Jochen0x90h/LedControl_old/Hardware2/Board/LedControl.kicad_pcb

## KiCad design Hardware2/Board/LedControl.kicad_pcb (2019-06-07)

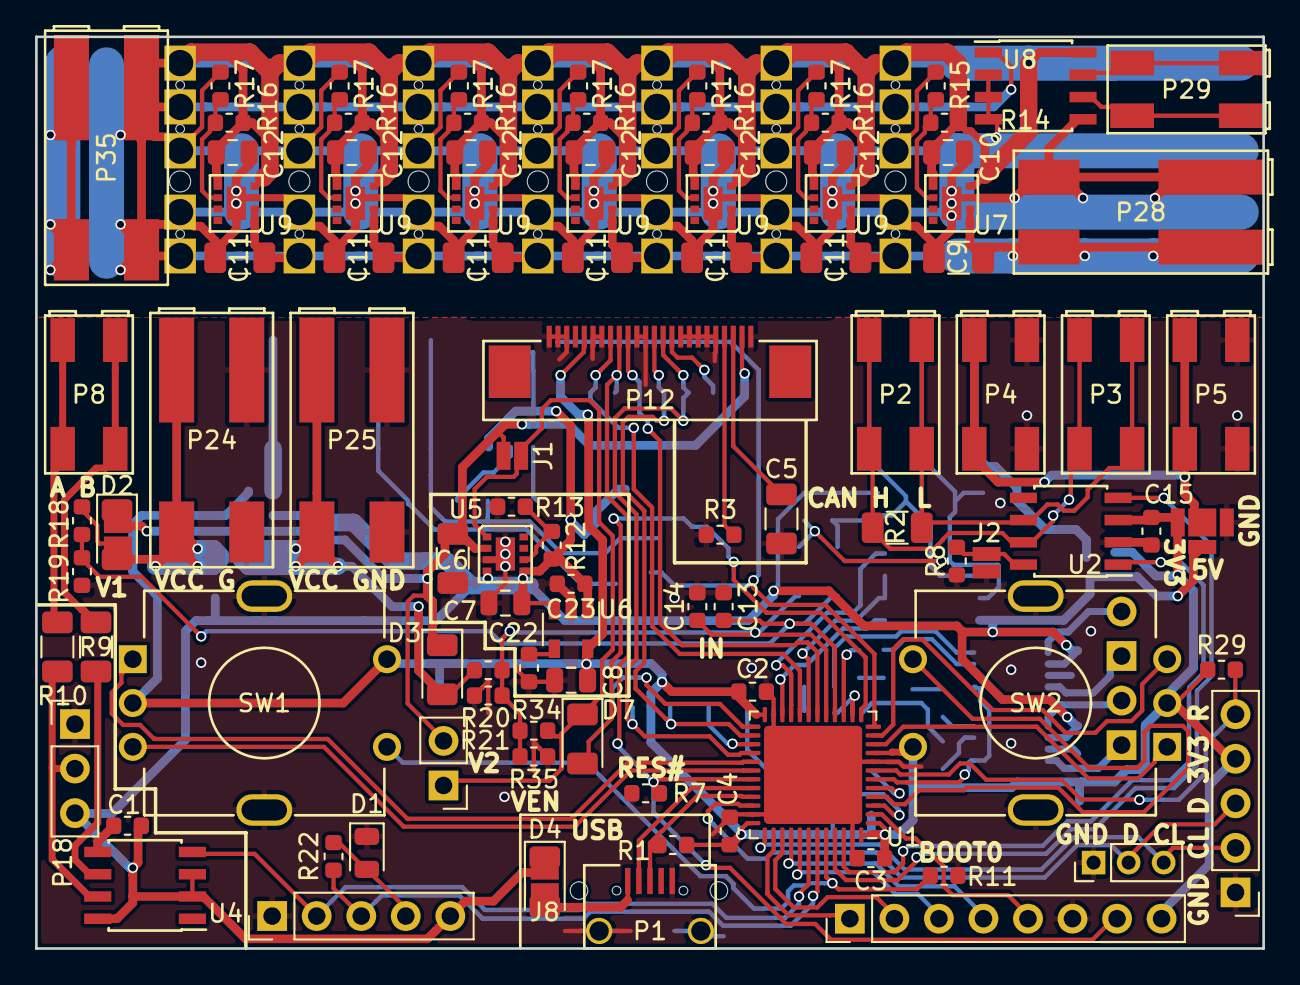
[picture p1: board LedControl.kicad_pcb from above]

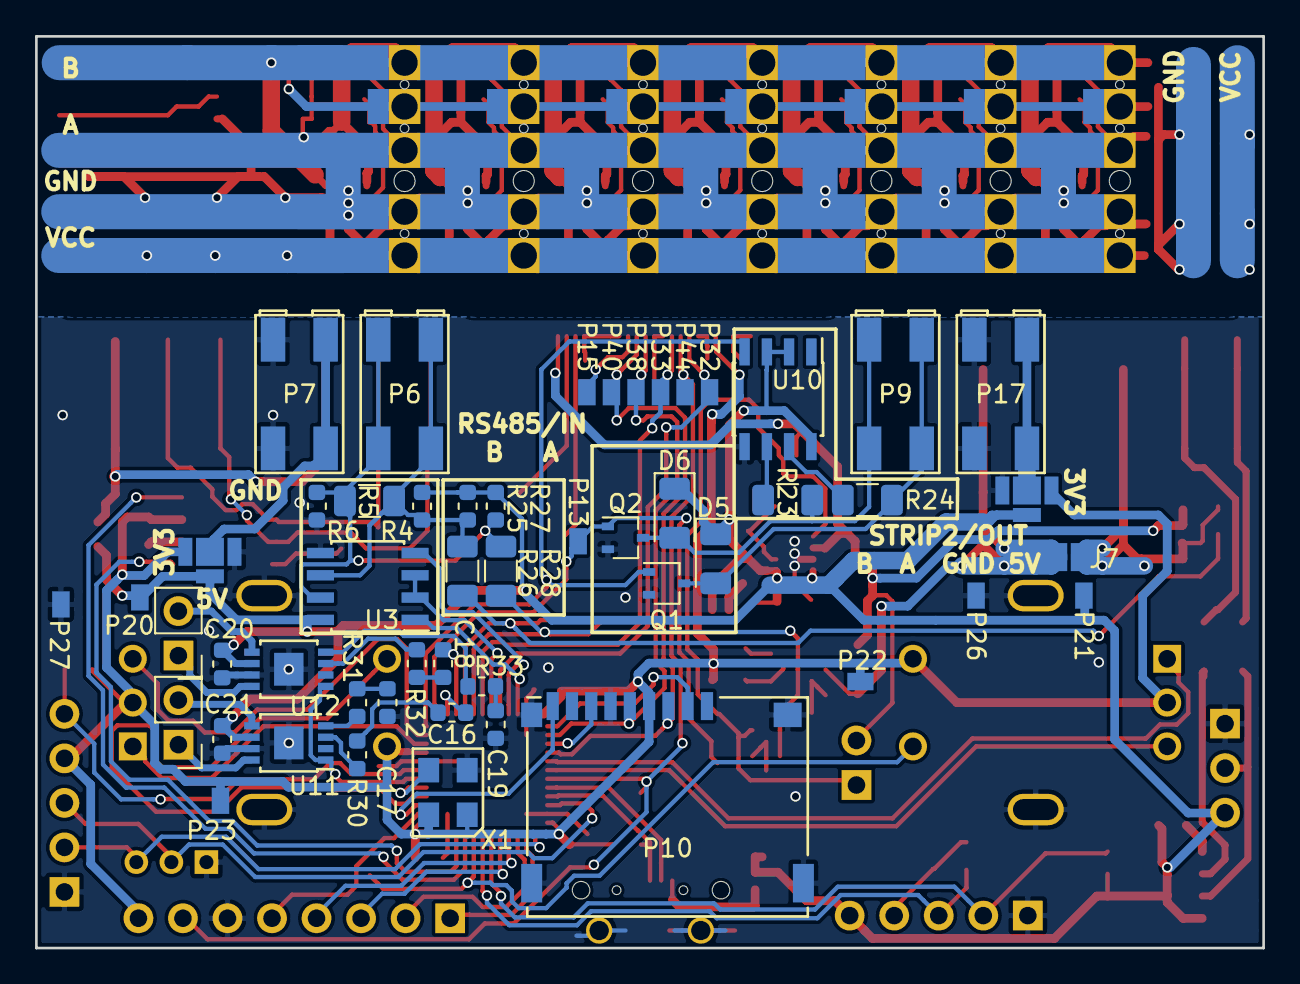
[picture p2: board LedControl.kicad_pcb from below]

Board: 2 copper layers, 70.0 x 52.0 mm, 163 parts (51 on the bottom side), 91 nets.

Parts:
C1, C2, C3, C4, C13, C14, C15, C20, C21, C23: 100n; C_0603_1608Metric
C5, C6, C9, C11, C11#2, C11#3, C11#4, C11#5, C11#6: 10u; C_1206_3216Metric
C7, C8, C10, C12, C12#2, C12#3, C12#4, C12#5, C12#6: 22u; C_0805_2012Metric
C16, C17, C18, C19: 100p; C_0603_1608Metric
C22: 10n; C_0603_1608Metric
D1: LED; LED_0805_2012Metric
D2, D3, D4, D5, D6, D7: SD1206S020S1R0; D_1206_3216Metric
DIVIDER1, DIVIDER2, DIVIDER3: Divider_22mm
J1, J2, J6, J7, J8: Jumper
J3, J4, J5: Jumper; Jumper3
P1: Micro_USB
P2, P3, P4, P5, P6, P7, P8, P9, P17, P29: 2059-302; WAGO_2059-302
P10: Micro_SD
P11, P16: Header; PinHeader_1x05_P2.54mm_Vertical
P12: DISPLAY; Connector_Flat_24_Pitch0.50mm
P13, P15, P20, P21, P22, P23, P26, P27, P32, P33, P38, P40, P44: TP; Pad
P14: TMM-103-03-G-S; PinHeader_1x03_P2.00mm_Vertical
P18: CONN_01X03; PinHeader_1x03_P2.54mm_Vertical
P19, P45, P46: Header; PinHeader_1x02_P2.54mm_Vertical
P24, P25, P28, P35: 2060-452; WAGO_2060-452
P30, P31, P31#2, P31#3, P31#4, P31#5, P31#6: LED_Strip
P37: Header; PinHeader_1x08_P2.54mm_Vertical
Q1, Q2: DMG1012UW; SOT-323_SC-70
R1: 1k5; R_0603_1608Metric
R2, R5, R9, R10, R23, R24, R26, R28: 120R; R_1206_3216Metric
R3: 1M2; R_0603_1608Metric
R4, R6, R22: 390R; R_0603_1608Metric
R7, R12, R14, R16, R16#2, R16#3, R16#4, R16#5, R16#6, R18, R20, R34: 52k3; R_0603_1608Metric
R8, R11, R13, R15, R17, R17#2, R17#3, R17#4, R17#5, R17#6, R19, R21, R25, R27, R29, R35: 10k; R_0603_1608Metric
R30, R31, R32, R33: 150k; R_0603_1608Metric
SW1, SW2: PEC12R-4215F-S0024; ALPS_BOURNS_EC12
U1: STM32L433CCUx; QFN-48-1EP_7x7mm_P0.5mm_EP5.6x5.6mm
U2: SN65HVD230; SOIC-8_3.9x4.9mm_P1.27mm
U3, U4, U8, U10: SP485CN; SOIC-8_3.9x4.9mm_P1.27mm
U5, U7, U9, U9#2, U9#3, U9#4, U9#5, U9#6: TPS82130
U6: LP2985IM5-3.3; SOT-23-5
U11, U12: TPA2005; MSOP-8-1EP_3x3mm_P0.65mm_EP1.68x1.88mm
X1: IQXO/7X; Oscillator_5x3.2mm

Connections:
+3V3: C2.1, C3.1, C4.1, C8.1, C15.1, J3.2, J4.2, J5.2, P10.4, P11.4, P12.5, P22.1, P23.1, P37.8, R1.2, R29.2, SW1.2, SW1.4, SW2.2, SW2.4, U1.1, U1.9, U1.24, U1.36, U1.48, U2.3, U6.5, X1.1, X1.4
+5V: C1.1, C7.1, C20.1, C21.1, C23.1, D4.1, D5.1, D6.1, J3.3, J4.3, J5.3, J8.2, P16.5, P18.3, P20.1, P21.1, R4.1, R12.1, R25.1, R27.1, U3.8, U4.2, U4.3, U4.8, U5.4, U5.5, U6.1, U6.3, U10.2, U10.3, U10.8, U11.6, U12.6
+5VD: C10.1, C12.1, C12#2.1, C12#3.1, C12#4.1, C12#5.1, C12#6.1, P30.5, P31.5, P31#2.5, P31#3.5, P31#4.5, P31#5.5, P31#6.5, R14.1, R16.1, R16#2.1, R16#3.1, R16#4.1, R16#5.1, R16#6.1, U7.4, U7.5, U8.8, U9.4, U9.5, U9#2.4, U9#2.5, U9#3.4, U9#3.5, U9#4.4, U9#4.5, U9#5.4, U9#5.5, U9#6.4, U9#6.5
/Power/EN: D7.1, J1.1, P19.1, R34.1, U5.1
AUDIO1: C16.2, U1.14
AUDIO2: C18.2, U1.15
CANH: P2.2, P3.2, R2.1, U2.7
CANL: P2.1, P3.1, R2.2, U2.6
CAN_RX: U1.45, U2.4
CAN_TX: U1.46, U2.1
DISP_D_C#: P12.10, P33.1, U1.18
DISP_NSS: P12.8, P32.1, U1.20
DISP_RFID_RES#: P12.9, P37.7, P44.1, R7.2, U1.31
DISP_SD_MOSI: P10.3, P12.14, P40.1, U1.28
DISP_SD_SCK: P10.5, P12.13, P38.1, U1.26
ENC1_CH1: SW1.1, U1.29
ENC1_CH2: SW1.3, U1.30
ENC1_SW: R11.2, SW1.5, U1.44
ENC2_CH1: SW2.1, U1.10
ENC2_CH2: SW2.3, U1.11
ENC2_SW: SW2.5, U1.4
GND: C1.2, C2.2, C3.2, C4.2, C5.2, C6.2, C7.2, C8.2, C13.2, C14.2, C15.2, C17.2, C19.2, C20.2, C21.2, C22.2, C23.2, D1.1, J2.1, J3.4, J4.4, J5.4, P1.5, P1.6, P4.1, P5.1, P7.2, P10.6, P10.10, P11.1, P12.1, P12.2, P12.3, P12.6, P12.7, P12.11, P12.12, P12.16, P12.17, P12.18, P12.19, P12.20, P12.24, P14.1, P16.1, P17.2, P18.1, P24.1, P25.1, P26.1, P27.1, P37.6, Q1.2, Q2.2, R3.1, R6.2, R7.1, R8.2, R11.1, R13.2, R19.2, R21.2, R35.2, SW1.6, SW2.6, U1.8, U1.23, U1.35, U1.47, U1.49, U2.2, U3.5, U4.5, U5.3, U5.9, U6.2, U10.5, U11.7, U11.9, U12.7, U12.9, X1.2
GNDD: C9.2, C10.2, C11.2, C11#2.2, C11#3.2, C11#4.2, C11#5.2, C11#6.2, C12.2, C12#2.2, C12#3.2, C12#4.2, C12#5.2, C12#6.2, P28.2, P30.2, P30.3, P31.2, P31.3, P31#2.2, P31#2.3, P31#3.2, P31#3.3, P31#4.2, P31#4.3, P31#5.2, P31#5.3, P31#6.2, P31#6.3, P35.1, R15.2, R17.2, R17#2.2, R17#3.2, R17#4.2, R17#5.2, R17#6.2, U7.3, U7.9, U8.2, U8.3, U8.4, U8.5, U9.3, U9.9, U9#2.3, U9#2.9, U9#3.3, U9#3.9, U9#4.3, U9#4.9, U9#5.3, U9#5.9, U9#6.3, U9#6.9
IN1: C13.1, R18.2, R19.1, R26.1, U1.16
IN2: C14.1, R20.2, R21.1, R28.1, R34.2, R35.1, U1.17
LED_TTY_RX: P16.3, R22.1, U1.43
NRST: P11.5, R29.1, U1.7
unnamed: C5.1, P12.22
unnamed: C9.1, C11.1, C11#2.1, C11#3.1, C11#4.1, C11#5.1, C11#6.1, P28.1, P30.1, P31.1, P31#2.1, P31#3.1, P31#4.1, P31#5.1, P31#6.1, P35.2, U7.1, U7.2, U9.1, U9.2, U9#2.1, U9#2.2, U9#3.1, U9#3.2, U9#4.1, U9#4.2, U9#5.1, U9#5.2, U9#6.1, U9#6.2
unnamed: C16.1, R30.2
unnamed: C17.1, R31.2
unnamed: C18.1, R32.2
unnamed: C19.1, R33.2
unnamed: C22.1, U6.4
unnamed: D1.2, P16.4, R22.2
unnamed: D2.2, J6.1, J7.2, P24.2, R18.1
unnamed: D3.2, J7.1, P25.2, R20.1
unnamed: D4.2, J8.1, P1.1
unnamed: J2.2, R8.1, U2.8
unnamed: J3.1, P4.2, P5.2
unnamed: J4.1, P7.1
unnamed: J5.1, P17.1
unnamed: P12.15, P15.1
unnamed: P12.21, R3.2
unnamed: P18.2, R10.1, U4.7
unnamed: P29.1, U8.6
unnamed: P29.2, U8.7
unnamed: P30.4, P31.4, P31#2.4, P31#3.4, P31#4.4, P31#5.4, P31#6.4, U8.1
unnamed: P45.1, U11.8
unnamed: P45.2, U11.5
unnamed: P46.1, U12.8
unnamed: P46.2, U12.5
unnamed: R9.1, U4.6
unnamed: R12.2, R13.1, U5.6
unnamed: R14.2, R15.1, U7.6
unnamed: R16.2, R16#2.2, R16#3.2, R16#4.2, R16#5.2, R16#6.2, R17.1, R17#2.1, R17#3.1, R17#4.1, R17#5.1, R17#6.1, U9.6, U9#2.6, U9#3.6, U9#4.6, U9#5.6, U9#6.6
unnamed: R23.1, U10.6
unnamed: R24.1, U10.7
unnamed: R30.1, U11.3
unnamed: R31.1, U11.4
unnamed: R32.1, U12.3
unnamed: R33.1, U12.4
unnamed: U1.5, X1.3
unnamed: U9.7, U9#2.7, U9#3.7, U9#4.7, U9#5.7, U9#6.7
unnamed: U9.8, U9#2.8, U9#3.8, U9#4.8, U9#5.8, U9#6.8
OUT2: D7.2, P13.1, Q2.1, U1.13
RFID_IRQ: P37.5, U1.2
RFID_MISO: P37.4, U1.40
RFID_MOSI: P37.3, U1.41
RFID_NSS: P37.1, U1.38
RFID_SCK: P37.2, U1.39
RS485A: P6.1, R4.2, R5.1, R25.2, R26.2, U3.6
RS485B: P6.2, R5.2, R6.1, R27.2, R28.2, U3.7
RS485_DE: U1.19, U3.2, U3.3
RS485_RX: U1.22, U3.1
RS485_TX: U1.21, U3.4
SD_DET: P10.9, U1.3
SD_MISO: P10.7, U1.27
SD_NSS: P10.2, U1.25
SHUTDOWN: U1.6, U11.1, U12.1
STRIP1_A: P8.2, R10.2
STRIP1_B: P8.1, R9.2
STRIP1_TTY_TX: P16.2, U1.42, U4.4
STRIP2_A: D5.2, P9.1, Q1.3, R24.2
STRIP2_B: D6.2, P9.2, Q2.3, R23.2
STRIP2_TX_OUT1: Q1.1, U1.12, U10.4
SWCLK: P11.2, P14.3, U1.37
SWDIO: P11.3, P14.2, U1.34
USB_DM: P1.2, U1.32
USB_DP: P1.3, R1.1, U1.33
VCC: C6.1, D2.1, D3.1, J1.2, J6.2, P12.23, P19.2, U5.2
