Jochen0x90h/LedControl_old/Hardware1/Board/LedControl.sch

## KiCad design Hardware1/Board/LedControl.sch (2018-09-01)

Schematic: LedControl.sch

Parts:
C1, C4, C5, C8: 100n; C_1206_HandSoldering
C2, C3: 100p; C_1206_HandSoldering
C6: 2n2; C_1206_HandSoldering
C7: 10u; C_1206_HandSoldering
D1, D2, D3, D4, D5, D6, D7, D8, D9, D10, D11, D12, D13, D14: LED; LED_0805_Hole
IC1: ATMEGA168A-A; TQFP-32_7x7mm_Pitch0.8mm
P1: CONN_02X05; Pin_Header_Straight_2x05
P2: CONN_01X04; Pin_Header_Straight_1x04
P3, P5, P10: CONN_02X02; WAGO_2509-302
P4, P6, P9, P12: CONN_01X01; Pin_Header_Straight_1x01
P7, P8: CONN_01X03; Pin_Header_Straight_1x03
P11: CONN_01X03; LED_Strip
R1: 3k5; R_1206_HandSoldering
R2, R7: 4k7; R_1206_HandSoldering
R3, R4: 100R; R_1206_HandSoldering
R5, R6: 120R; R_1206_HandSoldering
R8, R9: 100k; R_1206_HandSoldering
R10: 10k; R_1206_HandSoldering
RV1: POT; Potentiometer_Trimmer-Piher_PT6-V_horizontal
SW1: Rotary_Encoder_Switch
SW2, SW3, SW4: ROTARY_ENCODER; Encoder_Alps_EC12E
U1: 74LS132; SOIC-14_3.9x8.7mm_Pitch1.27mm
U2: MAX485; SOIC-8_3.9x4.9mm_Pitch1.27mm
X1: CRYSTAL_SMD; Resonator_3.2x1.3mm
