Jochen0x90h/LedControl_old/Emulator/Widget.cpp

#include <vector>
#include <stdexcept>
#include "Widget.h"


struct Vertex {
	float x, y;
};

// quad
static const Vertex vertices[6] = {
	{0.0f, 0.0f},
	{1.0f, 0.0f},
	{1.0f, 1.0f},
	{0.0f, 0.0f},
	{1.0f, 1.0f},
	{0.0f, 1.0f},
};

Widget::Widget(const char* fragmentShaderSource) {
	// create vertex shader
	GLuint vertexShader = createShader(GL_VERTEX_SHADER,
		"#version 150\n"
		"uniform vec2 scale;\n"
		"uniform vec2 offset;\n"
		"in vec2 position;\n"
		"out vec2 uv;\n"
		"void main() {\n"
		"	gl_Position = vec4(position * scale + offset, 0.0, 1.0);\n"
		"	uv = position;\n"
		"}\n");
	
	// create fragment shader
	GLuint fragmentShader = createShader(GL_FRAGMENT_SHADER, fragmentShaderSource);
	
	// create and link program
	this->program = glCreateProgram();
	glAttachShader(this->program, vertexShader);
	glAttachShader(this->program, fragmentShader);
	glLinkProgram(this->program);

	// get uniform locations
	this->scaleLocation = glGetUniformLocation(this->program, "scale");
	this->offsetLocation = glGetUniformLocation(this->program, "offset");
	GLuint positionLocation = glGetAttribLocation(this->program, "position");
	glUseProgram(this->program);
	glUniform1i(glGetUniformLocation(this->program, "tex"), 0);
	glUseProgram(0);

	// create vertex buffer containing a quad
	glGenBuffers(1, &this->vertexBuffer);
	glBindBuffer(GL_ARRAY_BUFFER, this->vertexBuffer);
	glBufferData(GL_ARRAY_BUFFER, sizeof(vertices), vertices, GL_STATIC_DRAW);

	// create vertex array objct
	glGenVertexArrays(1, &this->vertexArray);
	glBindVertexArray(this->vertexArray);
	glEnableVertexAttribArray(positionLocation);
	glVertexAttribPointer(positionLocation, 2, GL_FLOAT, GL_FALSE, sizeof(Vertex), (void*)0);
	glBindBuffer(GL_ARRAY_BUFFER, 0);
	glBindVertexArray(0);
}

Widget::~Widget() {
}

bool Widget::contains(float x, float y) {
	return x >= this->x1 && x <= this->x2 && y >= this->y1 && y <= this->y2;
}

void Widget::touch(float x, float y) {
}

void Widget::draw() {
	// use program
	glUseProgram(this->program);
	
	// set uniforms
	glUniform2f(this->scaleLocation, (this->x2 - this->x1) * 2.0f, (this->y2 - this->y1) * 2.0f);
	glUniform2f(this->offsetLocation, this->x1 * 2.0f - 1.0f, this->y1 * 2.0f - 1.0f);
	
	// set vertex array
	glBindVertexArray(this->vertexArray);

	setState();
	
	// draw
	glDrawArrays(GL_TRIANGLES, 0, 6);
	
	resetState();
	
	// reset
	glBindVertexArray(0);
}

void Widget::setState() {
}

void Widget::resetState() {
}

GLuint Widget::createShader(GLenum type, const char* code) {
	GLuint shader = glCreateShader(type);
	glShaderSource(shader, 1, &code, NULL);
	glCompileShader(shader);
	
	// check status
	GLint success;
	glGetShaderiv(shader, GL_COMPILE_STATUS, &success);
	if (!success) {
		// get length of log (including trailing null character)
		GLint length;
		glGetShaderiv(shader, GL_INFO_LOG_LENGTH, &length);
	
		// get log
		std::vector<char> errorLog(length);
		glGetShaderInfoLog(shader, length, &length, (GLchar*)errorLog.data());
		
		throw std::runtime_error(errorLog.data());
	}
	return shader;
}

void Widget::setTextureIndex(char const * name, int index) {
	glUseProgram(this->program);
	glUniform1i(glGetUniformLocation(this->program, name), index);
	glUseProgram(0);
}
