Jochen0x90h/LedControl_old/(commit log)

2017-03-20 adds casing
    [LedControl.scad]
2017-03-26 finalizes poti holders in wheels and cover
    [LedControl.scad]
2017-10-03 add board using KiCad
    [LedControl.kicad_pcb, LedControl.scad, LedControl.sch, Power.sch]
2018-02-09 Finished schematic
    [LedControl.kicad_pcb, LedControl.scad, LedControl.sch, Power.sch]
2018-04-01 Finished routing main board
    [LedControl.kicad_pcb, LedControl.scad, LedControl.sch, Power.sch]
2018-04-20 routing nearly finished
    [LedControl.kicad_pcb, LedControl.sch, Power.sch]
2018-06-04 add winter, spring and summer effects
    [LedControl.scad]
2018-09-01 add schematic of old ATmega based board
    [LedControl.sch]
2018-12-23 Start software for stm32 based hardware2
    [LedControl.sch]
2019-02-08 continuing software for stm32
2019-02-20 Update to KiCad 5.0.1, add debug connector
    [LedControl.kicad_pcb, LedControl.sch, Power.sch]
2019-02-27 Board is ready for production, needs last review
    [LedControl.kicad_pcb, LedControl.scad, LedControl.sch]
2019-03-11 LED strip power supply below strip
    [LedControl.kicad_pcb, LedControl.scad, LedControl.sch, Power.sch]
2019-05-03 Add CAN bus
    [LedControl.kicad_pcb, LedControl.scad, LedControl.sch, Power.sch]
2019-05-11 USB and SD card at center
    [LedControl.kicad_pcb, LedControl.sch]
2019-06-07 add rfid and speaker
    [LedControl.kicad_pcb, LedControl.scad, LedControl.sch, Power.sch]
